andreeadurla2000/Fitness_tracker/README.md

# Fitness_tracker
Acest proiect reprezinta un dispozitiv folosit pentru a contoriza numarul de pasi si, totodata, are functia de cronometru. 
Video prezentare proiect: https://www.youtube.com/watch?v=sBwnaY9RVpE&feature=youtu.be
